Rtdassh/animatronico/docs/plano_circuito_animatronico.png

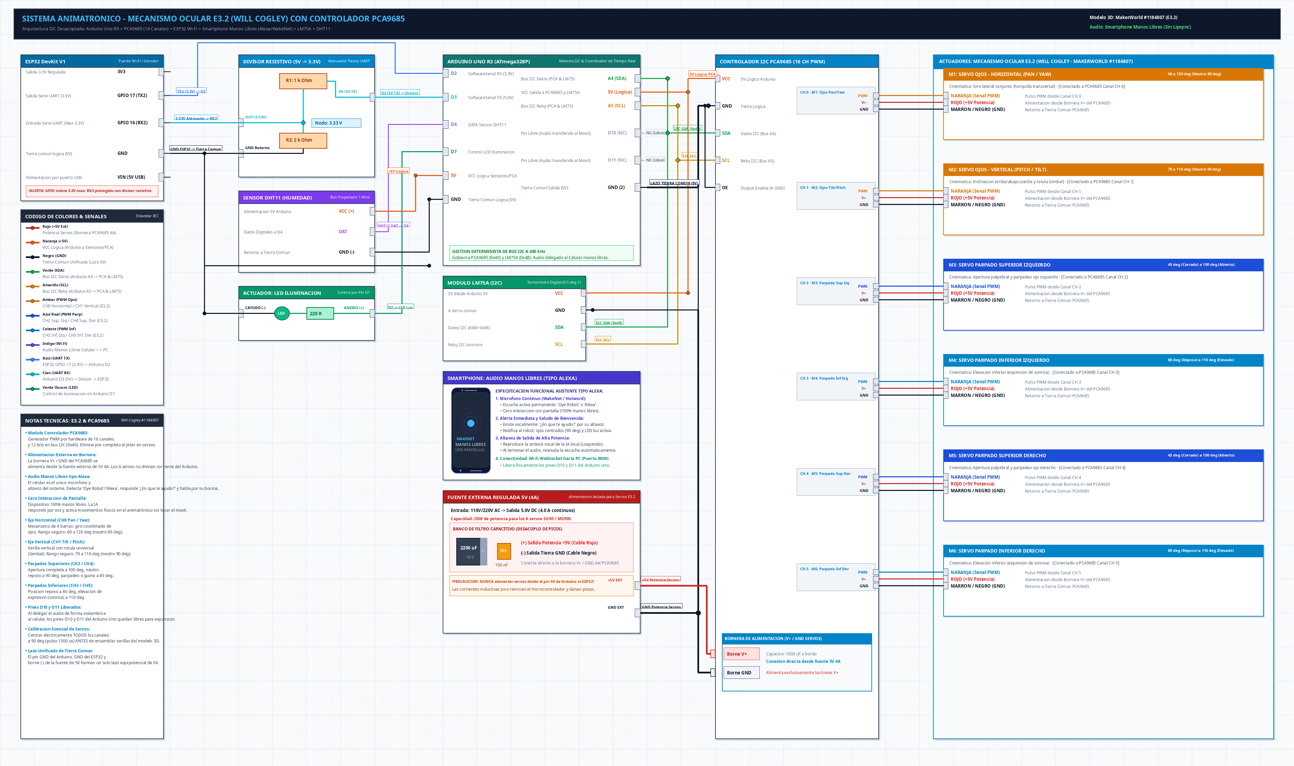
docs/plano_circuito_animatronico.png
