Rtdassh/animatronico/(commit log)

2026-11-06 feat: Integrar servidor local, IA con Ollama Qwen 2.5, sintesis Loquendo y tunel movil HTTPS
    - Motor LLM: Inferencia local con Ollama (Qwen 2.5:7b) con contexto de telemetria LM75A/DHT11 y deteccion de comandos de luz.
    - Sintesis de voz: Motor Loquendo (Jorge, Carlos, Carmen) con chunking de oraciones y cache en disco MD5.
    - Captura de audio: Grabacion PCM WAV 16kHz en cliente web y transcriptor STT en servidor.
    - Lip-Sync y hardware: Reenvio de tramas lipsync y control de servos por WebSocket al ESP32 y Arduino Uno.
    - Enlace movil: Lanzador con tunel Cloudflare HTTPS y generador de codigo QR para iOS Safari y Android Chrome.
2026-11-06 feat: Integrar esqueleto de cliente Voicebox IA y robustecer servidor local
    - Esqueleto Voicebox: Cliente de integracion con el servicio local (puerto 17493) con deteccion dinamica de perfiles sin datos privados ni modelos de voz en el repositorio.
    - Privacidad: Exclusion estricta en .gitignore de perfiles locales (voicebox_profile/), muestras de audio y archivos temporales.
    - Servidor local: Deteccion y liberacion automatica de puerto ocupado (8000) y limpieza automatica de tunel.
    - Entorno Windows: Priorizacion de Python 3.13 y deteccion py launcher en scripts start.bat.
2026-11-07 feat: arquitectura manos libres tipo Alexa, retiro de DFPlayer y utilidades de flasheo
    - Smartphone como nodo exclusivo de audio (micrófono continuo WakeNet y altavoz)
    - Prompt de activación instantáneo '¿En qué te ayudo?' y postura de alerta en robot
    - Liberación de pines D10 y D11 en Arduino Uno y retiro de módulo DFPlayer
    - Actualización de esquema eléctrico ampliado (plano_circuito_animatronico.png)
    - Generación de binarios precompilados en firmware/binarios/ (Arduino y ESP32)
    - Scripts ejecutables de flasheo para Linux (.sh) y Windows (.bat) con detección de puertos
    - Actualización de documentación técnica (README.md, DOC_01, DOC_03, plano interactivo)
2026-11-09 feat: optimizaciones de rendimiento, modo conversacional V de Venganza y manos libres 'Oye V'
    - Desacoplamiento multihilo de vision artificial (CameraCaptureWorker) a >160 FPS y 3.6ms de latencia.
    - Optimizacion UART ESP32-Arduino a 38400 bps con politica Latest-Command-Wins no bloqueante.
    - Integracion de personalidad 'V de Venganza' con herramientas de agente (fecha, agenda, memoria) y corpus de frases iconicas de Loquendo (Iván Carrera) con humor roto (JAJAJAJA, XD XD XD).
    - Correccion del catalogo de voces Loquendo (Carlos en espanol, eliminacion de Leonor, adicion de Diego, Esperanza, Juan, Francisca, Daniel y Dave).
    - Activacion de manos libres actualizada a 'Oye V' / 'Oye Uve' con sa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
2026-11-10 feat: soporte para ejecucion en Linux con venv, opencv fijado y cloudflared
2026-11-10 feat: adaptacion de Asistente de Escritorio autonomo (Gran Hermano) con diagnostico web movil, firmware Arduino/ESP32, esquematicos y documentacion
2026-11-10 feat: navegacion por pestanas en panel web con control cinematico para 16 canales PCA9685
2026-11-10 feat: scripts y herramientas de grabado oficiales para Asistente Completo (Arduino Uno y ESP32)
2026-11-10 feat(comms): correccion visual del avatar y adaptador serie bidireccional USB para ESP32
2026-11-10 implementacion de servos
2026-11-11 cambios de adaptación
2026-11-11 feat: pasarela universal ESP32 conectada al Hotspot de Windows y resolucion dinamica de gateway
2026-11-11 feat(vision): unificar control de camara/vision en interfaz web y sincronizar baudrate UART a 38400 bps
2026-11-11 fix(vision): serializar face_box como lista de enteros nativos y robustecer websocket
    [app.py, vision_tracker.py]
2026-11-11 feat(asistente): consolidar motor STT multi-fuente, audios loquendo y consistencia UART 38400 bps
2026-11-11 feat(asistente): acelerar whisper en GPU, ampliar wake words, telemetria directa arduino/esp32 y correccion de UI
    - Whisper large-v3-turbo acelerado por CUDA con cuBLAS/cuDNN en GPU NVIDIA RTX
    - Deteccion automatica y enlace serie directo para Arduino Uno (COM7) y ESP32 (COM8)
    - Fallback de temperatura DHT11 en firmware de Arduino Uno ante ausencia de LM75A
    - Wake words foneticos en frontend: 'Dom dom', 'Oye Libni', 'Oye V', 'Robot', 'Oye Google'
    - Optimizacion de interfaz movil, controles de servos PCA9685 y herramientas de agenda
